Klaus-00/Thrust-Stand-LiftUp/hardware/immagini/banco_laterale.jpg

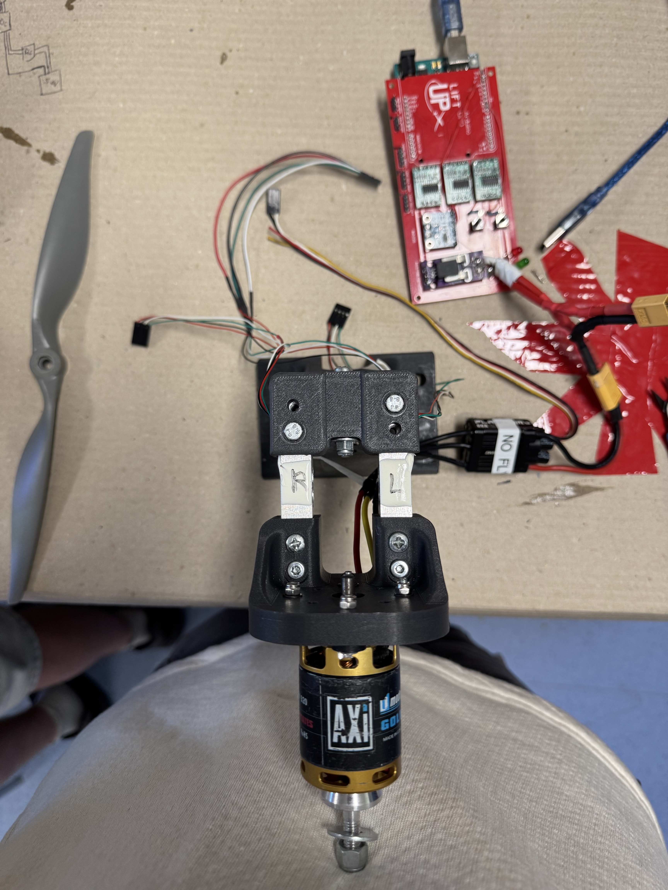
hardware/immagini/banco_laterale.jpg
