Klaus-00/Thrust-Stand-LiftUp/hardware/immagini/pcb_fronte.jpg

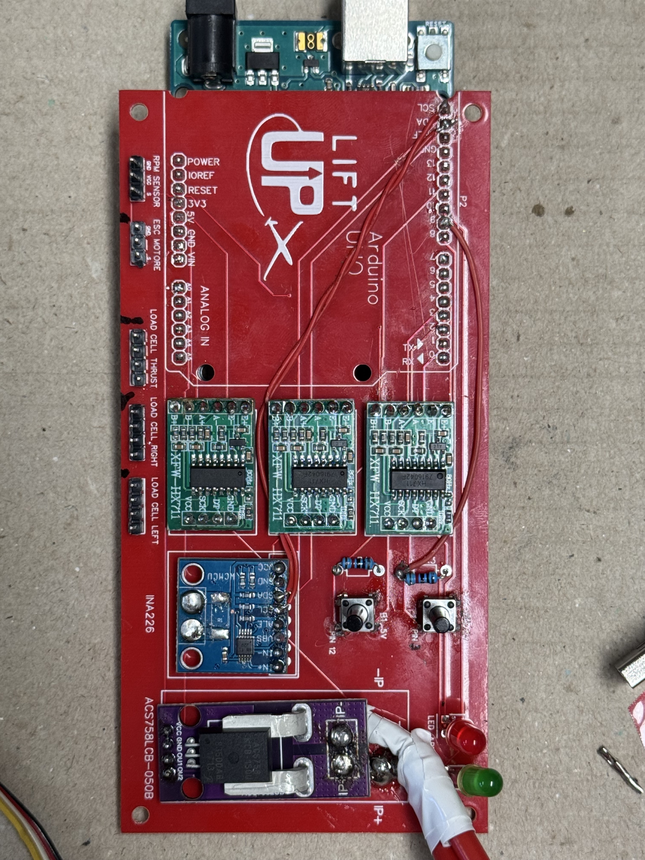
hardware/immagini/pcb_fronte.jpg
