Klaus-00/Thrust-Stand-LiftUp/hardware/PDF_PCB_liftup.pdf

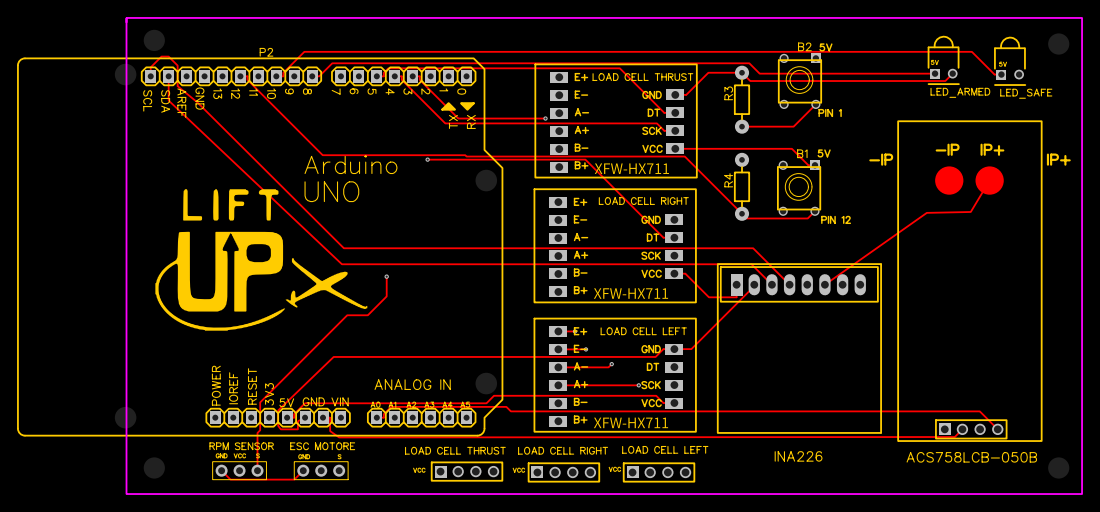
[picture p4: page 1]
