Klaus-00/Thrust-Stand-LiftUp/hardware/immagini/setup_completo.jpg

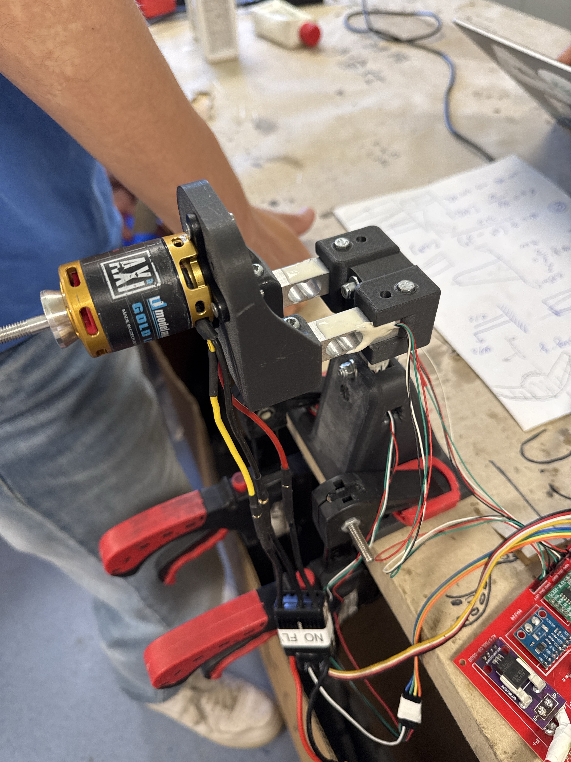
hardware/immagini/setup_completo.jpg
